ligius-/DieselTuningBox/(commit log)

2016-05-06 Create DieselBooster.ino
    This is just a simple prototype for testing the proof of concept. It's based on an Arduino Nano with HC05 module and a few passives for filtering the power supply and smoothing the PWM output.
    See http://hackcorrelation.blogspot.com/2016/05/designing-better-diesel-tuning-box-part_5.html for details and supported commands.
2016-05-06 Add DieselBooster.ods
    Spreadsheet for visualising and generating the tuning curves. Made for OpenOffice Calc.
    [DieselBooster.ods]
2016-05-23 Update DieselBooster.ino
    Fixed EEPROM saving (char vs. byte).
    Added help command.
    More sensible default values.
    [DieselBooster.ino]
2016-08-11 Add schematic for version 2
